KimchiLab/Camus/README.md

# Camus
Camera for homecage recordings of Mus musculus mice  
**"the whole of life can be summed up in an image"** - Albert Camus, *Between Yes and No*

### Contributors
Eyal Y. Kimchi  
Tushya Mehta  
Andrew Si-Zu Lu  
Nicholas Angulo  
Silas Staten-Lusty  
Vincent Im  
Riya Palkar  
Cyrus Nadazideh  
Grace Steward  
Camellia Neda Nakhjiri  
Ylang Guo  

This package also makes use of modifications of the pygrabber python package, released under the MIT license at https://github.com/bunkahle/pygrabber  

### Sample Image
The following is a representative image of Camus recordings, from a camera placed on the ceiling within a standard lab mouse homecage. The homecage is housed on a standard individually ventilated cage (IVC) rack.    
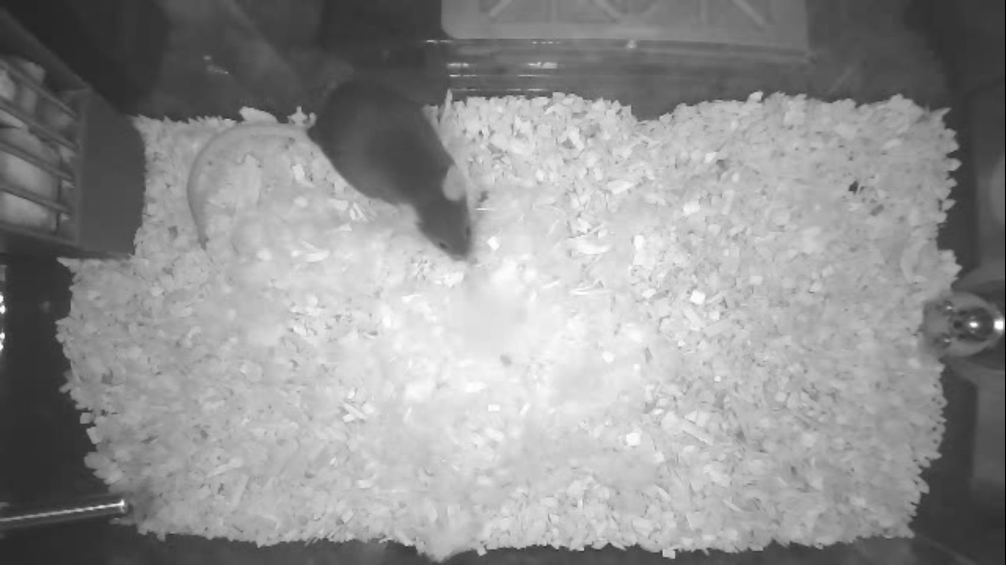
[picture p1: Examples/SampleCamusImageSingleMouse.jpg]
Sample Camus Image Single Mouse


### Repository Organization
The repository is split into Hardware and Code folders.
1. [Hardware](Hardware): Contains instructions and designs for building and setting up cameras
2. [Code](Code): Contains instructions and code for installing the software to collect and analyze data.

## Planned Additions
1. We will be updating 

### Preprints/Publications
Camus: a video-based framework for continuous behavioral monitoring in the mouse home-cage  
Tushya Mehta, Nicholas Angulo, Andrew Lu, Silas Staten-Lusty, Vincent Im, Riya Palkar, Cyrus Nadazideh, Grace Steward, Camelia Nakhjiri, Ylang Guo, Eyal Y Kimchi  
doi: https://doi.org/10.64898/2026.10.23.761437  
https://www.biorxiv.org/content/10.64898/2026.10.23.761437v1
