KimchiLab/Camus/Hardware/Figures/5b245129-4217-4f2a-90bd-1b663b835d09.jpg

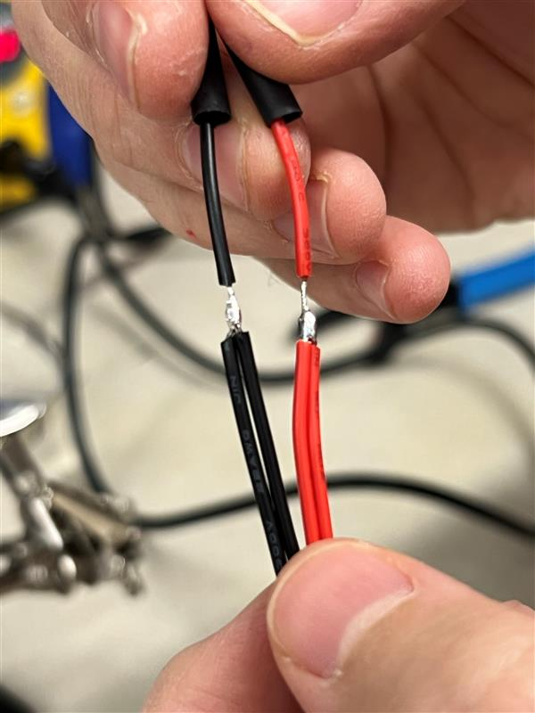
Hardware/Figures/5b245129-4217-4f2a-90bd-1b663b835d09.jpg
