KimchiLab/Camus/Hardware/Figures/68ceea74-401a-4e5f-a09a-84337bc96400.jpg

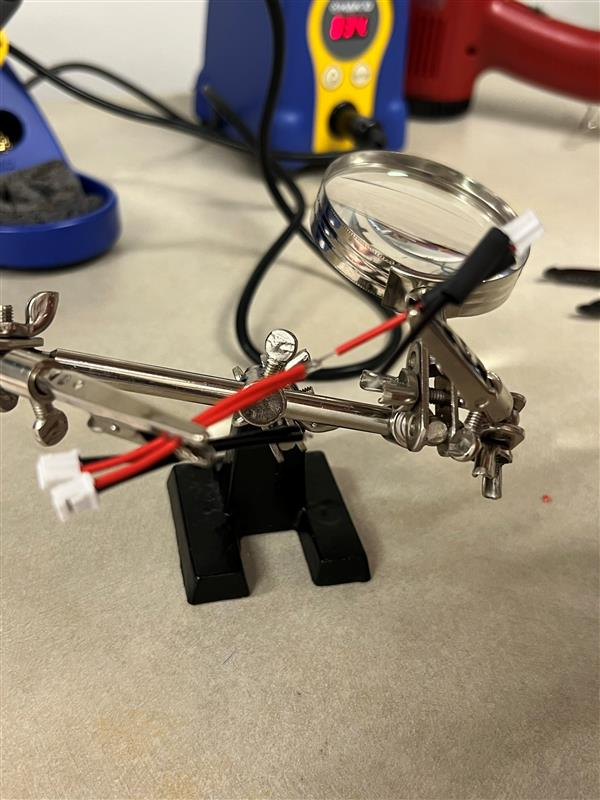
Hardware/Figures/68ceea74-401a-4e5f-a09a-84337bc96400.jpg
