KimchiLab/Camus/Hardware/Figures/food.jpeg

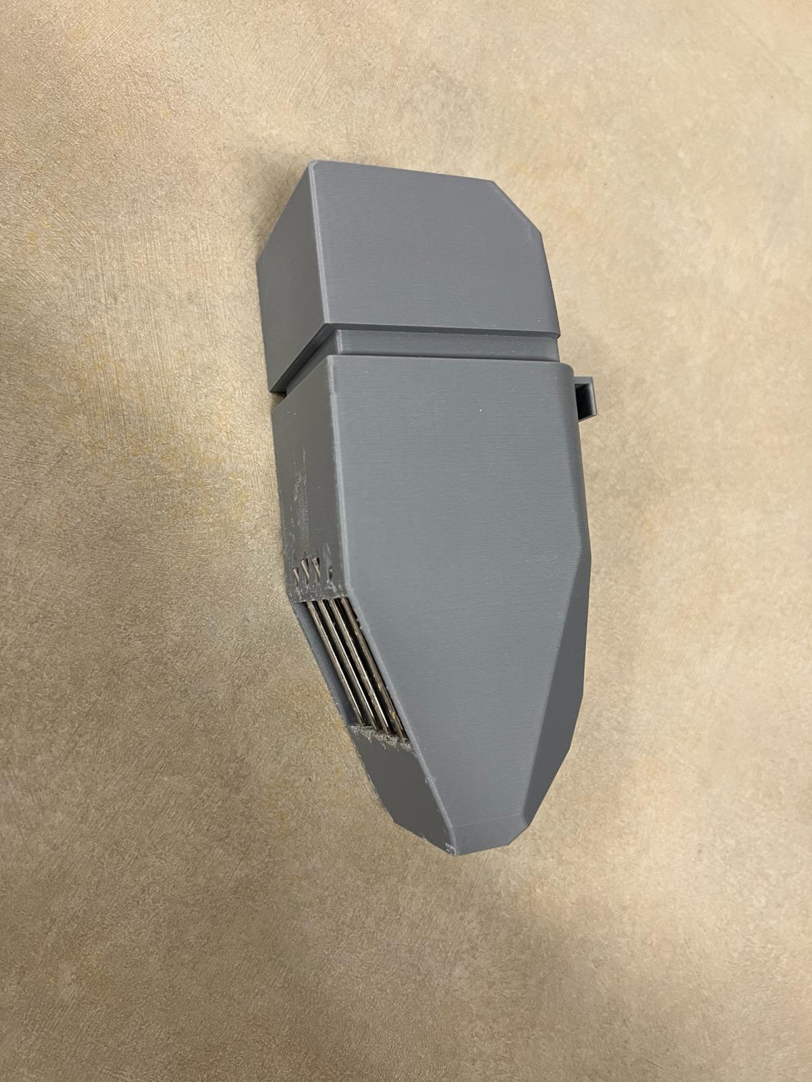
Hardware/Figures/food.jpeg
