KimchiLab/Camus/Hardware/Figures/led connected (2).jpeg

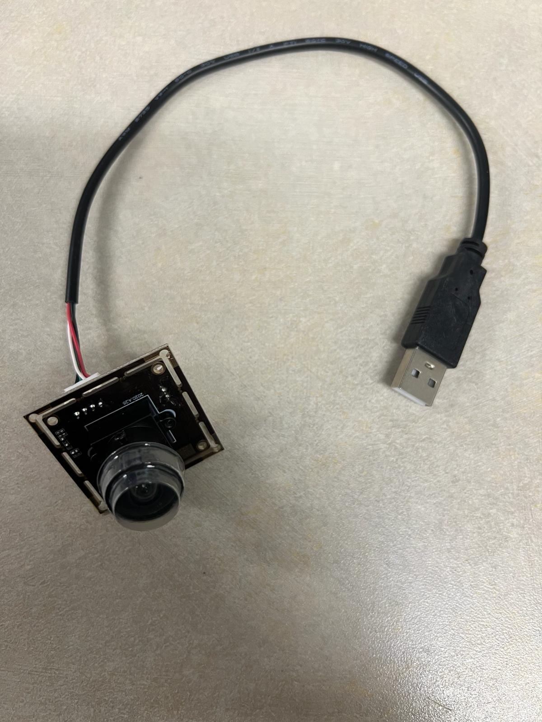
Hardware/Figures/led connected (2).jpeg
