KimchiLab/Camus/Hardware/Figures/pt 1.jpeg

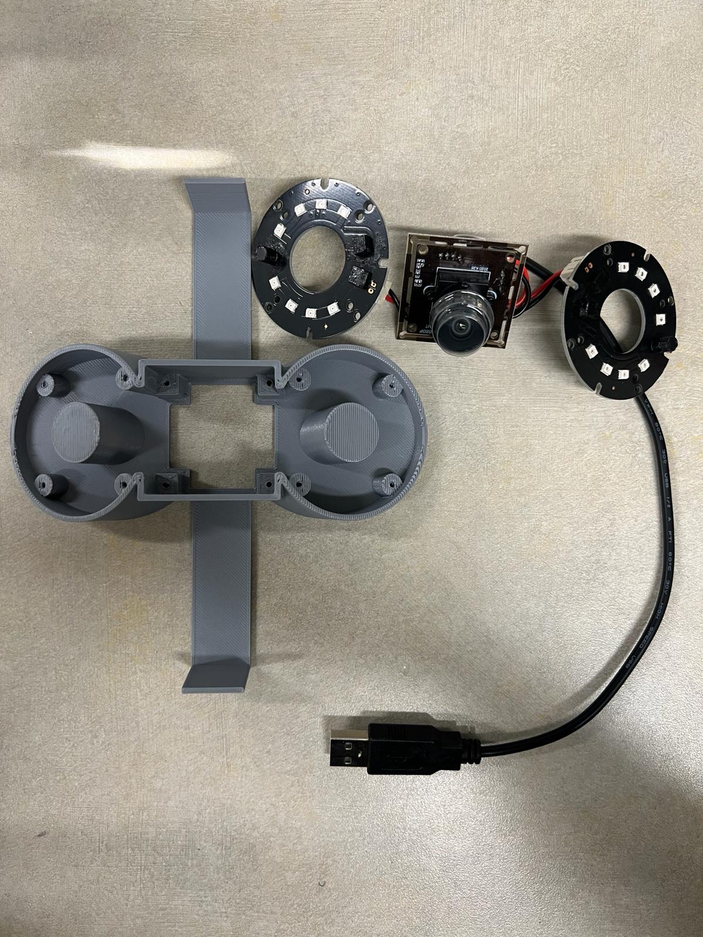
Hardware/Figures/pt 1.jpeg
