KimchiLab/Camus/Hardware/Figures/pt 3.jpeg

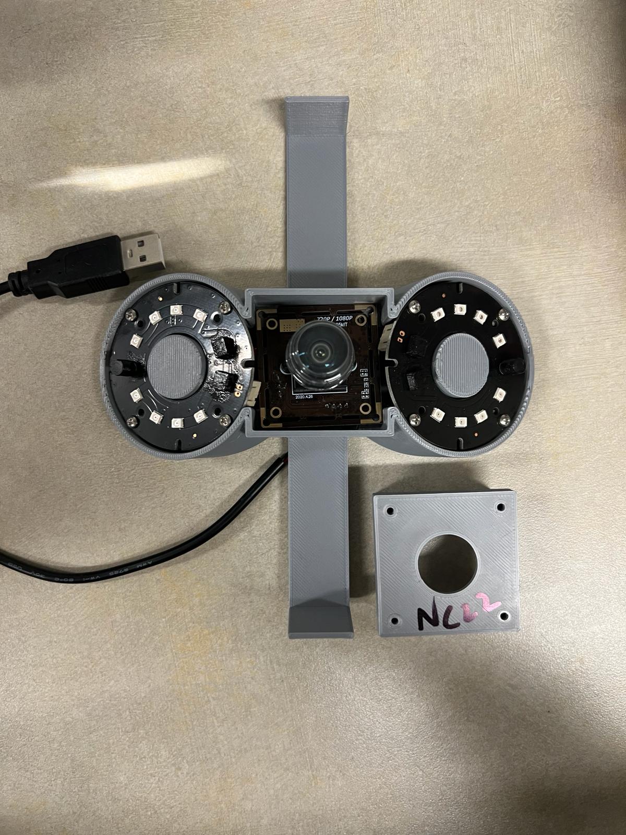
Hardware/Figures/pt 3.jpeg
