KimchiLab/Camus/Hardware/Figures/small tape thingy to stabalize pt2.jpeg

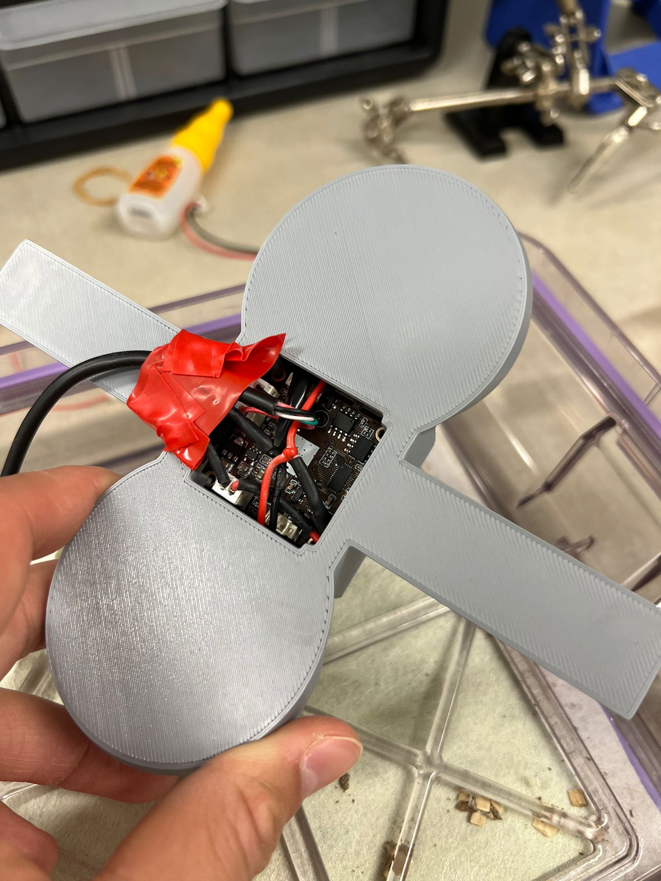
Hardware/Figures/small tape thingy to stabalize pt2.jpeg
