KimchiLab/Camus/Hardware/Figures/WhatsApp Image 2024-01-26 at 5.35.12 PM (2).jpeg

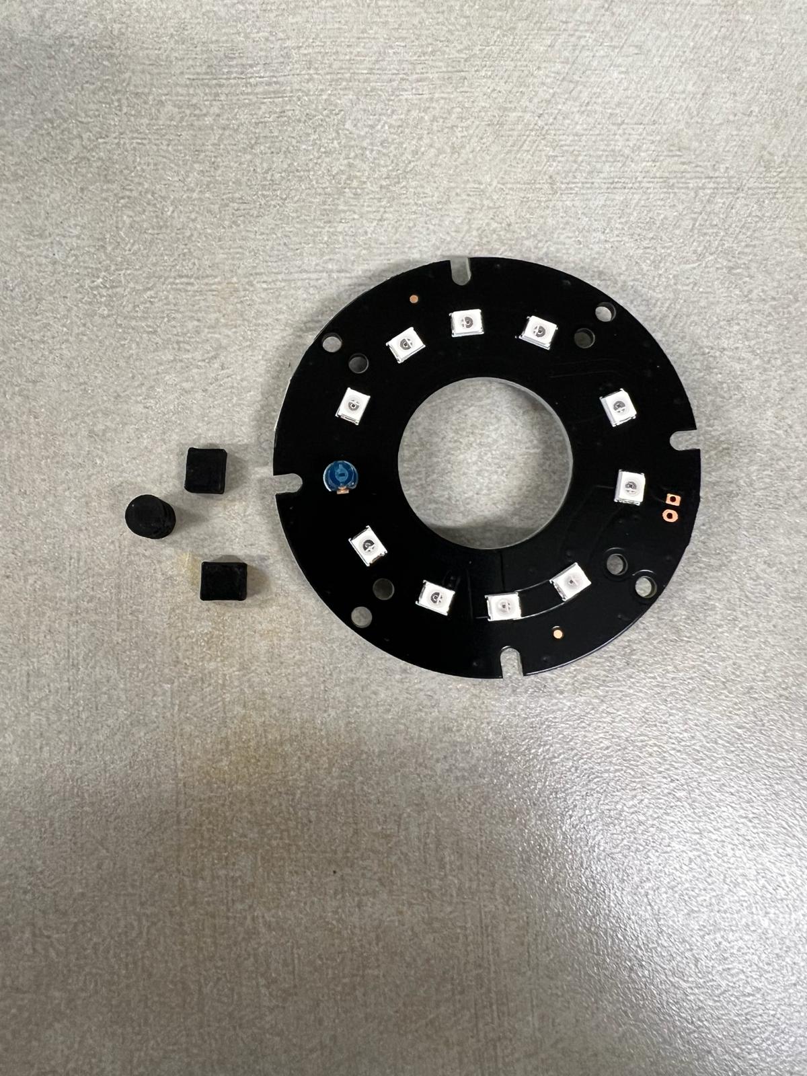
Hardware/Figures/WhatsApp Image 2024-01-26 at 5.35.12 PM (2).jpeg
