KimchiLab/Camus/Hardware/CamusPartsList.xlsx

Sheet: Camera Parts
Part Information | Needed Per Camera | For 20 | Notes | Unit Price | Cost Per Group | Manufacturer | Web | Alternative
Camera: ELP-USBFHD05MT-RH120 | 1 | 20 |  | $60.00 | $1200.00 | ELP | http://www.webcamerausb.com/2mp-1080p-usb-camera-c-42/?page=5
USB Cable for the camera | 1 | 20 |  | $1.03 | $20.60 | ELP | https://www.aliexpress.us/item/3256805417099241.html?gatewayAdapt=glo2usa
USB extension cable | 1 | 20 |  | $23.74 | $474.80 | Tripp Lite | https://www.amazon.com/Tripp-Lite-Hi-Speed-Extension-U026-016/dp/B0002D6QJO?th=1
LED Panels (IRXS10-120) | 2 | 40 | 120 degree panels for diffuse light | $7.20 | $288.00 | Spinel | https://www.spinelelectronics.com/product/irxs10-30/
JST cables | 1.5 | 30 | Need 1.5 for each, Come with camera | 0 | $0.00
Water Bottle: 80ml Hamster Small Pets Water Drinking Bottle Plastic Hangable Water Bottle | 1 | 20 |  | $0.91 | $18.20 | Sheep Famile House Store | https://www.aliexpress.us/item/3256806092078340.html | https://www.aliexpress.us/item/3256802367372956.html
Metal bars | 1 | 20 | Cut with saw to fit length of hopper | $8.90 | $178.00 | Grainger | https://www.grainger.com/product/GRAINGER-APPROVED-Stainless-Steel-Rod-303-3-796DH6
Screw: 3/16" screws (8) | 8 | 160 | Price includes 100 screws | $2.58 | $412.80 | Grainger | https://www.grainger.com/product/GRAINGER-APPROVED-Machine-Screw-2-56-Thread-1ZB22
Screw: 1 1/8" screws (4) | 4 | 80 | Price includes 100 screws | $4.14 | $331.20 | Grainger | https://www.grainger.com/product/Machine-Screw-2-56-Thread-1ZB21
Printer Filament (meters) | 85.79 | 1715.8 | in meters | $0.07 | $114.33
Stucco Tape |  | 1 |  | $11.48 | $11.48 | 3M | https://www.homedepot.com/p/3M-1-88-in-x-60-yds-48-mm-x-54-8-m-Stucco-Tape-3262/309077649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
Computer costs (for 20) |  | 0 | See Computer Parts sheet |  | $1879.52
 |  |  |  |  | $246.45
 |  |  |  |  |  |  |  |  | TOTAL Camera cost
 |  |  |  |  |  |  |  |  | $120.05

Sheet: 3dPrinted Parts
3d Printer Part | Quantitiy for 1 cage | Estimated Time to Print (min) | Estimated amount of filament (meters)
Hopper Cap & Hopper | 1 | 338 | 38.54
 | 1
Water Bottle Holder | 1 | 90 | 9.04
Water Bottle Holder Cap | 1 | 41 | 4.06
Camera Holder & Cover | 1 | 171 | 17.25
Photosensor Caps | 2 | 4 | 0.1
IR LED Caps | 4 | 8 | 0.24
Cage Cover Insert | 1 | 76 | 6.19
Cable Covers | 1 | 68 | 6.11
Cable Rings | 1 | 43 | 4.26
Total: |  | 839 | 85.79

Sheet: Computer Parts
Item | Vendor | VendorPart | Quantity | Unit Price | Total Price | Manufacturer | MfgPart | Web
RAIJINTEK THETIS Silver Classic, Alu. ATX PC Case, Supports Max. 280mm Length VGA Card, 170mm Height CPU Coolers, 4X HDDs,240mm Radiator on top, 1x 12025 LED Fan pre-Installed, 2X USB3.0, 7X PCI Slot | Amazon | B01MQS5IWM | 1 | 122.9 | $122.90 | RAIJINTEK | THETIS Classic | https://www.amazon.com/RAIJINTEK-Classic-Supports-Radiator-pre-Installed/dp/B01MQS5IWM/ref=sr_1_2
Corsair RM Series, RM750, 750 Watt, 80+ Gold Certified, Fully Modular Power Supply, Microsoft Modern Standby | Amazon | B07RF237B1 | 1 | 199.99 | $199.99 | Corsair | ‎CP-9020195-NA | https://www.amazon.com/CORSAIR-Certified-Modular-Microsoft-Standby/dp/B07RF237B1
ASUS Prime A620-PLUS WiFi Socket AM5 (LGA 1718) Ryzen 7000 Gaming Motherboard(DDR5,Dual M.2 Slots,DisplayPort/HDMI,Wi-Fi 5,Front USB 3.2 Gen 1 Type-C,Two-Way AI Noise Cancelation, Aura Sync) Heart 1 | Amazon | B0CBQW2C41 | 1 | 139.99 | $139.99 | ASUS | Prime A620-PLUS WiFi | https://www.amazon.com/ASUS-A620-PLUS-Motherboard-DisplayPort-Cancelation/dp/B0CBQW2C41/ref=sr_1_1
AMD Ryzen™ 9 7950X 16-Core, 32-Thread Unlocked Desktop Processor | Amazon | B0BBHD5D8Y | 1 | 536.91 | $536.91 |  |  | https://www.amazon.com/AMD-Ryzen-5950X-32-Thread-Processor/dp/B0815Y8J9N
Thermalright Phantom Spirit 120 SE Black CPU Cooler,Dual TL-C12B V2 PWM Fans and Double Towers, 7 Heat Pipes Heatsink Cooler,for AM4/AM5&Intel LGA1851/1700/115X/1200, Computer CPU Cooling,Black | Amazon | B0D93R3YY9 | 1 | 36.59 | $36.59 | ThermalRight | PS120SE BLACK | https://www.amazon.com/dp/B0D93R3YY9
CORSAIR VENGEANCE DDR5 RAM 32GB (2x16GB) 4800MHz CL40 Intel XMP iCUE Compatible Computer Memory - Black (CMK32GX5M2A4800C40) | Amazon | B09MTS5YH1 | 1 | 92.99 | $92.99 |  |  | https://www.amazon.com/CORSAIR-VENGEANCE-4800MHz-Compatible-Computer/dp/B09MTS5YH1?s=electronics
WD_BLACK SN850X NVMe SSD WDS400T2X0E - SSD - 4 TB - PCIe 4.0 x4 (NVMe) | CDWG | 7134252 | 1 | 372.16 | $372.16 | WD | WDS400T2X0E | https://www.cdwg.com/product/wd-black-sn850x-nvme-ssd-wds400t2x0e-ssd-4-tb-pcie-4.0-x4-nvme/7134252?pfm=srh
MHQJRH M.2 2280 SSD heatsink, Double-Sided Heat Sink, with Thermal Silicone pad for PC / PS5 M.2 PCIE NVMe SSD or M.2 SATA SSD | Amazon | B07KDDKDNN | 1 | 8.99 | $8.99 |  |  | https://www.amazon.com/heatsink-double-sided-matching-thermal-silicone/dp/B07KDDKDNN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
StarTech.com 4 Port USB 3.0 PCIe Card w/ 4 Dedicated Channels - UASP 5Gbps | CDWG | 3255376 | 4 | 92.25 | $369.00 | StarTech | PEXUSB3S44V | https://www.cdwg.com/product/startech.com-4-port-usb-3.0-pcie-card-w-4-dedicated-channels-uasp/3255376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
 |  |  |  |  | $1879.52

Sheet: Animal Facility Parts
Part Information | Description | Manufacturer
Rack- Allentown NexGen IVC system rack |  | Allentown
Blower - Ecoflo blower: Allentown |  | Allentown
Allentown Nexgen 500 Mouse cage (Standard cage) | Micro barrier top | Allentown
Animal Feed | Teklad LM-485 Mouse/Rat sterilizable diet | Teklad
Bedding (Aspen Sani Chips) | Heat treated coarse bedding | Nepco
Nestlet (NES360) | Compacted cotton fiber nesting material | Gusmer Enterprises
Used at Northwestern, but not in Camus: | Description | Manufacturer
Plastic igloo (K3327Mouse Igloo, Red | Red Igloo for mice | Bio-serv
Safe Harbor (K3583 Safe Harbor mouse retreat) | Red safe harbor for mice | Bio-serv
