KimchiLab/Camus/Hardware/3dPrint/CableRing/CableRingDuo.stl

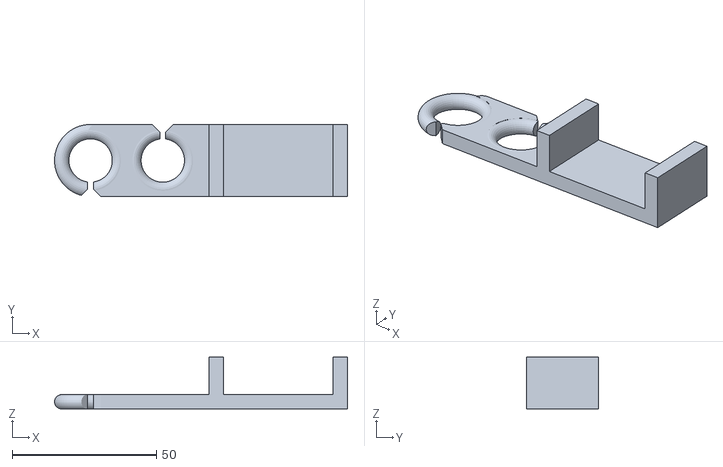
[picture p40: CAD file, 2026-10-27]
Hardware/3dPrint/CableRing/CableRingDuo.stl
101.5 x 25.0 x 18.0
