KimchiLab/Camus/Hardware/3dPrint/CageTopInsertGrating/CageTopInsertGrating.stl

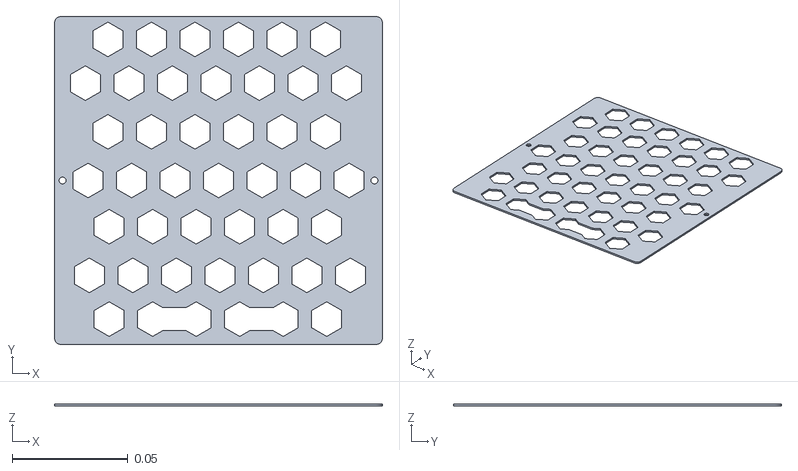
[picture p41: CAD file, 2026-10-27]
Hardware/3dPrint/CageTopInsertGrating/CageTopInsertGrating.stl
0.142 x 0.142 x 0.001
