KimchiLab/Camus/Hardware/3dPrint/CameraHolder/CameraHolder_UsbCover_100.stl

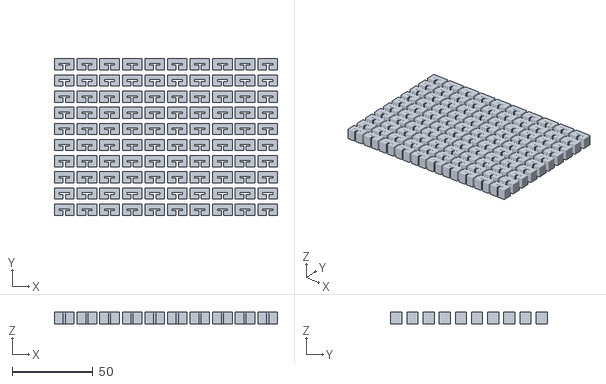
[picture p42: CAD file, 2026-10-27]
Hardware/3dPrint/CameraHolder/CameraHolder_UsbCover_100.stl
138.2 x 97.0 x 7.50
