KimchiLab/Camus/Hardware/3dPrint/FoodHopper/Food Hopper_Hopper.stl

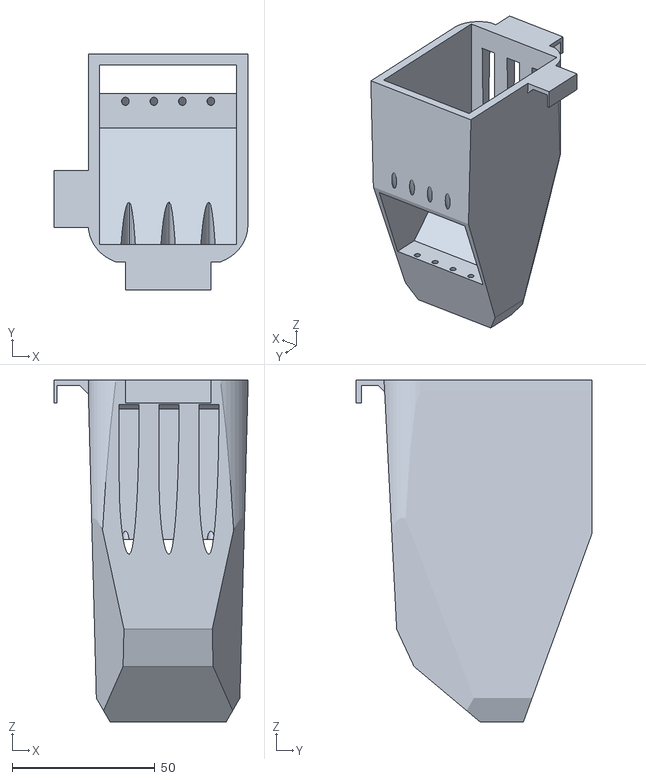
[picture p43: CAD file, 2026-10-27]
Hardware/3dPrint/FoodHopper/Food Hopper_Hopper.stl
68.0 x 82.9 x 120.0
