KimchiLab/Camus/Hardware/3dPrint/WaterBottleHolder/WaterBottleCap.stl

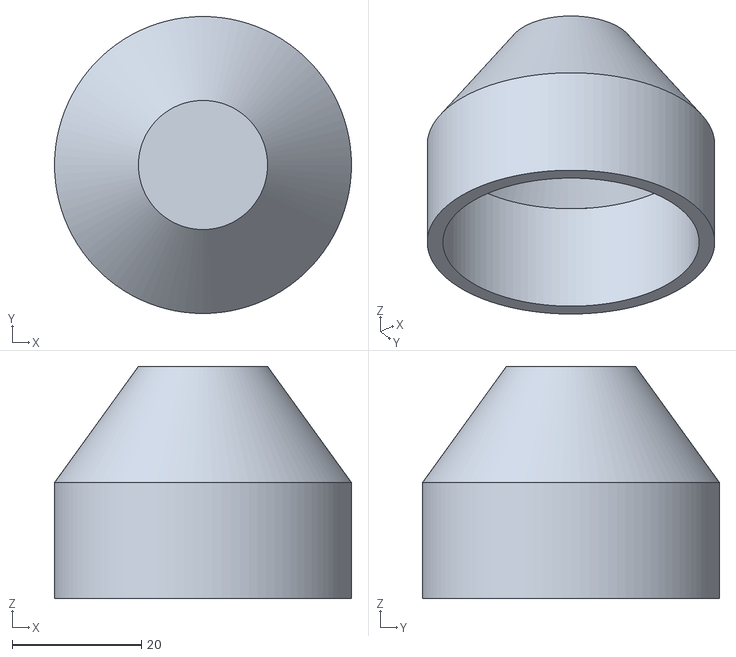
[picture p45: CAD file, 2026-10-27]
Hardware/3dPrint/WaterBottleHolder/WaterBottleCap.stl
46.0 x 46.0 x 36.0
