KimchiLab/Camus/Hardware/3dPrint/CameraHolder/CameraHolder_FlatLedCap_Spinel.stl

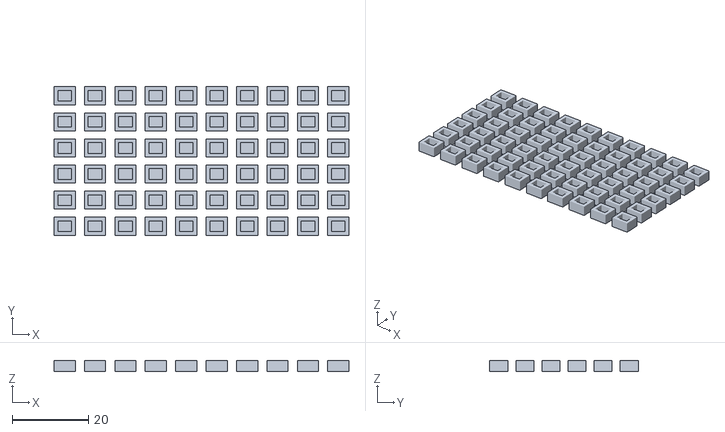
[picture p46: CAD file, 2026-10-27]
Hardware/3dPrint/CameraHolder/CameraHolder_FlatLedCap_Spinel.stl
77.6 x 39.1 x 3.00
