KimchiLab/Camus/Hardware/3dPrint/FoodHopper/Food Hopper_Cap.stl

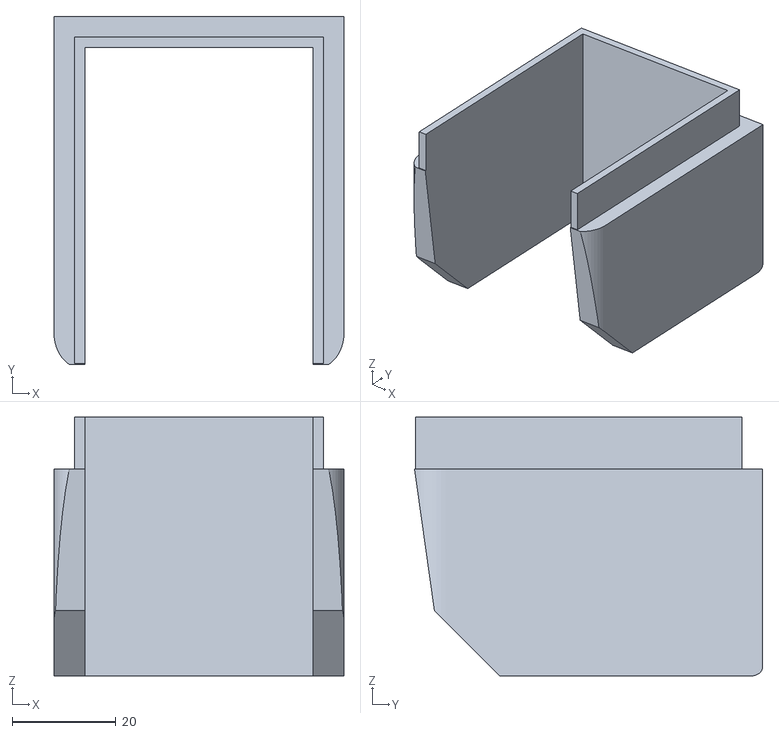
[picture p47: CAD file, 2026-10-27]
Hardware/3dPrint/FoodHopper/Food Hopper_Cap.stl
56.0 x 67.2 x 50.0
