KimchiLab/Camus/Hardware/3dPrint/UsbCover/CameraHolder_UsbCover_ActiveExt_TrippLite_Lower.stl

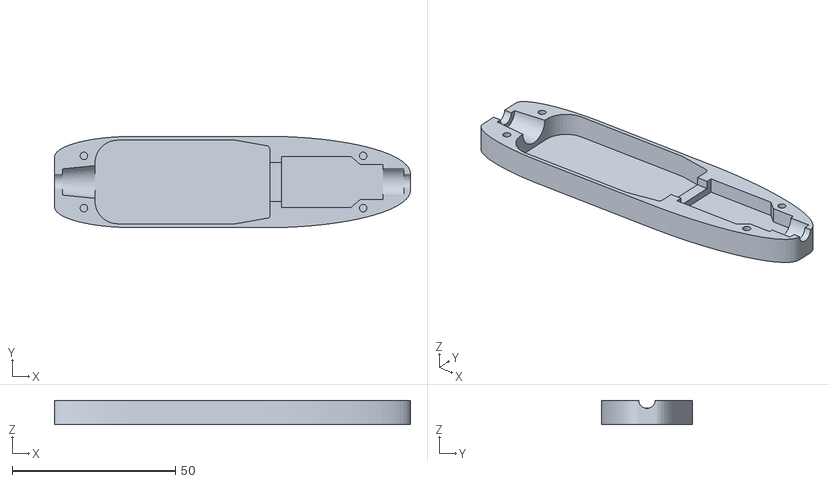
[picture p48: CAD file, 2026-10-27]
Hardware/3dPrint/UsbCover/CameraHolder_UsbCover_ActiveExt_TrippLite_Lower.stl
109.0 x 28.0 x 7.50
