KimchiLab/Camus/Hardware/3dPrint/WaterBottleHolder/WaterBottleHolder.stl

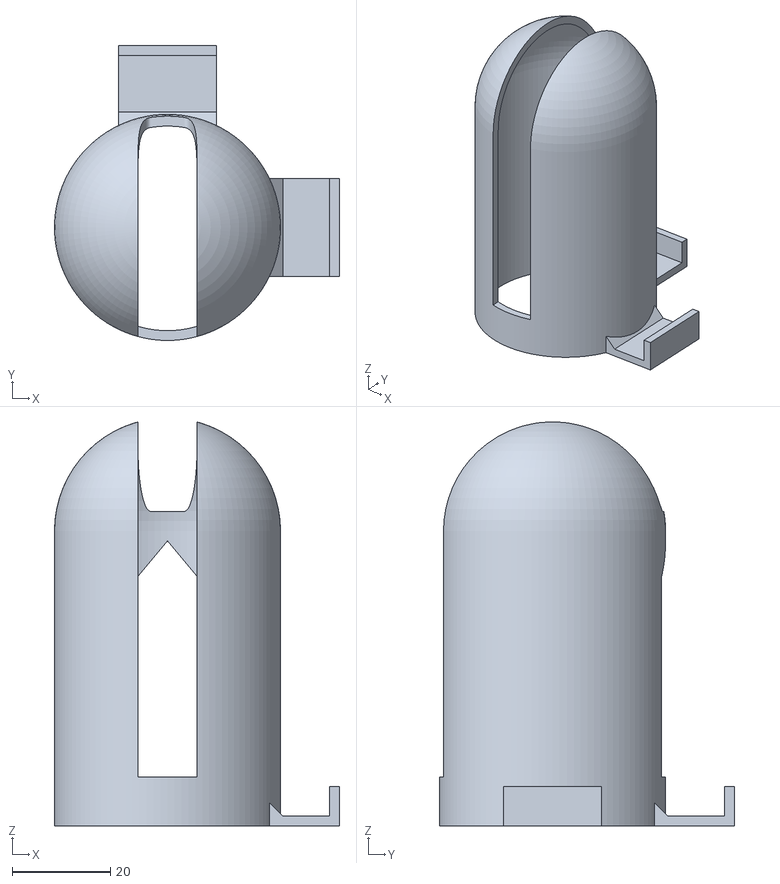
[picture p49: CAD file, 2026-10-27]
Hardware/3dPrint/WaterBottleHolder/WaterBottleHolder.stl
58.0 x 60.0 x 82.2
