KimchiLab/Camus/Hardware/3dPrint/CameraHolder/CameraHolder_PhotosensorCap_Spinel_Array.stl

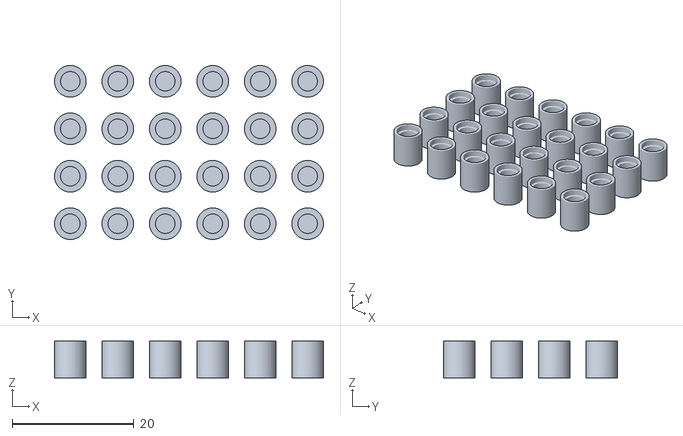
[picture p50: CAD file, 2026-10-27]
Hardware/3dPrint/CameraHolder/CameraHolder_PhotosensorCap_Spinel_Array.stl
44.2 x 28.6 x 6.00
