KimchiLab/Camus/Hardware/3dPrint/UsbCover/CameraHolder_UsbCover_NonActiveExt_C2G_Lower.stl

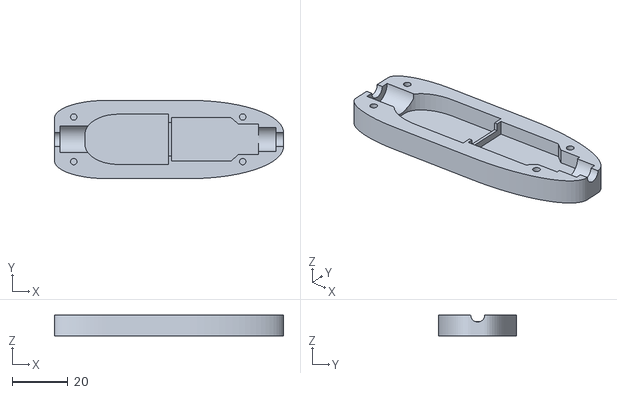
[picture p51: CAD file, 2026-10-27]
Hardware/3dPrint/UsbCover/CameraHolder_UsbCover_NonActiveExt_C2G_Lower.stl
82.0 x 28.0 x 7.50
