KimchiLab/Camus/Hardware/3dPrint/WaterBottleHolder/WaterBottleDryingRack.stl

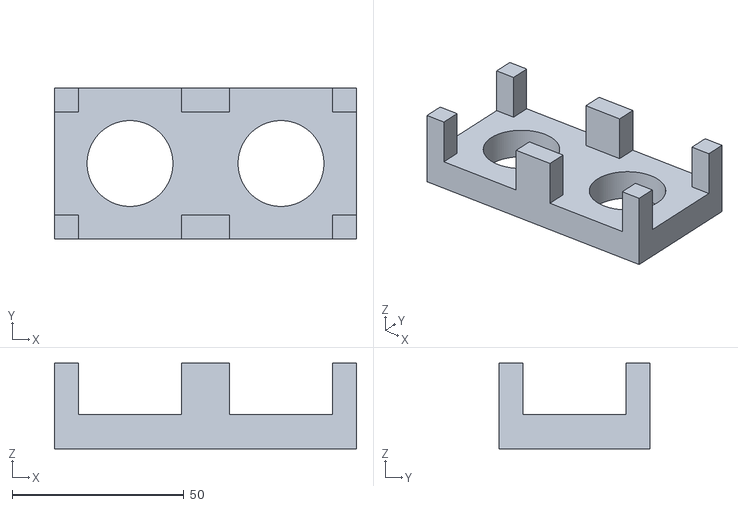
[picture p52: CAD file, 2026-10-27]
Hardware/3dPrint/WaterBottleHolder/WaterBottleDryingRack.stl
88.0 x 44.0 x 25.0
