KimchiLab/Camus/Hardware/3dPrint/CameraHolder/CameraHolder_UsbCover.stl

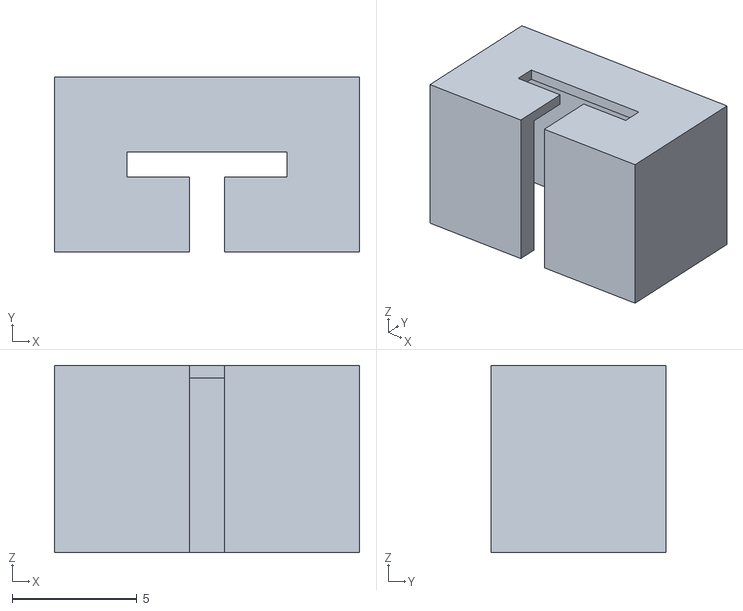
[picture p53: CAD file, 2026-10-27]
Hardware/3dPrint/CameraHolder/CameraHolder_UsbCover.stl
12.2 x 7.00 x 7.50
