KimchiLab/Camus/Hardware/3dPrint/CameraHolder/CameraHolder_Led_Spinel.stl

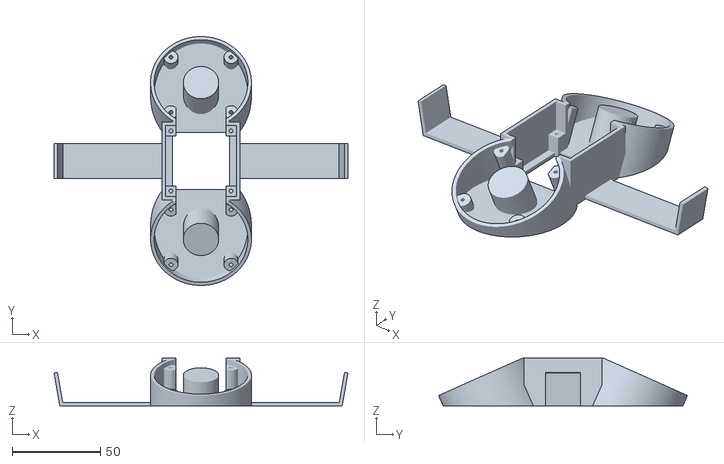
[picture p54: CAD file, 2026-10-27]
Hardware/3dPrint/CameraHolder/CameraHolder_Led_Spinel.stl
166.2 x 140.7 x 27.0
