KimchiLab/Camus/Hardware/3dPrint/CameraHolder/CameraHolder_CameraCover_Spinel.stl

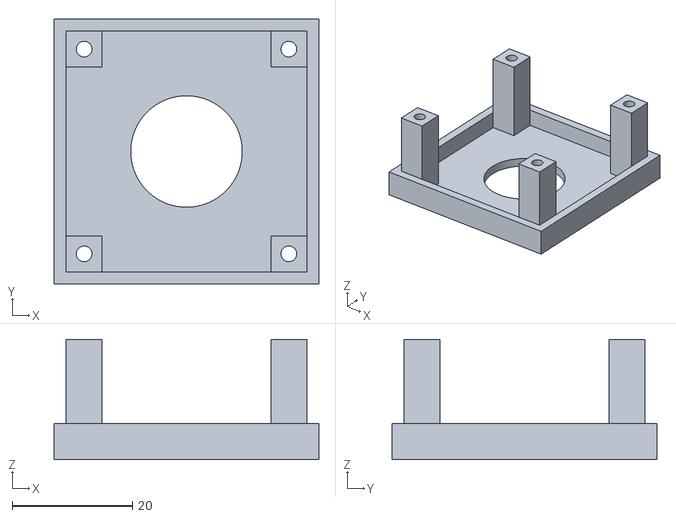
[picture p55: CAD file, 2026-10-27]
Hardware/3dPrint/CameraHolder/CameraHolder_CameraCover_Spinel.stl
44.0 x 44.0 x 20.0
