KimchiLab/Camus/Hardware/3dPrint/UsbCover/CameraHolder_UsbCover_ActiveExt_Monoprice_Upper.stl

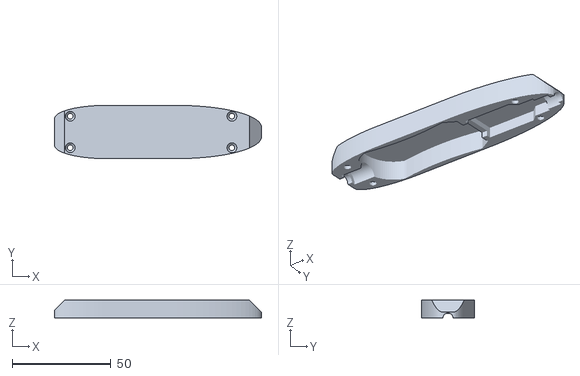
[picture p56: CAD file, 2026-10-27]
Hardware/3dPrint/UsbCover/CameraHolder_UsbCover_ActiveExt_Monoprice_Upper.stl
105.0 x 27.0 x 9.00
