KimchiLab/Camus/Hardware/3dPrint/UsbCover/CameraHolder_UsbCover_NonActiveExt_TrippLite.stl

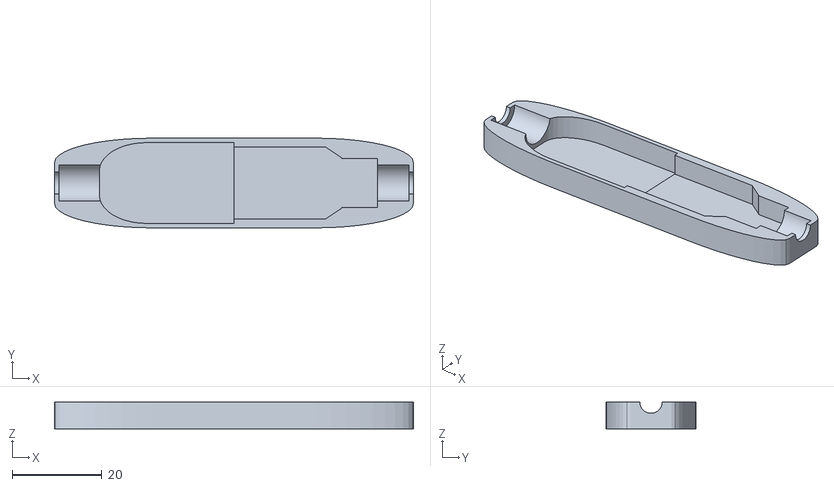
[picture p58: CAD file, 2026-10-27]
Hardware/3dPrint/UsbCover/CameraHolder_UsbCover_NonActiveExt_TrippLite.stl
80.0 x 20.0 x 6.00
