KimchiLab/Camus/(list of files, cad)

Other CAD files:
Hardware/3dPrint/UsbCover/CameraHolder_UsbCover_NonActiveExt_BESGOOD_Upper.stl
Hardware/3dPrint/UsbCover/CameraHolder_UsbCover_NonActiveExt_BESGOOD_Lower.stl
Hardware/3dPrint/UsbCover/CameraHolder_UsbCover_ActiveExt_TrippLite_Upper.stl
Hardware/3dPrint/CableRing/CableRingDuo.blend
Hardware/3dPrint/CageTopInsertGrating/CageTopInsertGrating.blend
Hardware/3dPrint/CameraHolder/CameraHolder_CameraCover_Spinel.blend
Hardware/3dPrint/CameraHolder/CameraHolder_FlatLedCap_Spinel.blend
Hardware/3dPrint/CameraHolder/CameraHolder_Led_Spinel.blend
Hardware/3dPrint/CameraHolder/CameraHolder_PhotosensorCap_Spinel.blend
Hardware/3dPrint/CameraHolder/CameraHolder_UsbCover.blend
Hardware/3dPrint/FoodHopper/Food Hopper.blend
Hardware/3dPrint/UsbCover/CameraHolder_UsbCover_ActiveExt_Monoprice.blend
Hardware/3dPrint/UsbCover/CameraHolder_UsbCover_ActiveExt_TrippLite.blend
Hardware/3dPrint/UsbCover/CameraHolder_UsbCover_NonActiveExt_BESGOOD.blend
Hardware/3dPrint/UsbCover/CameraHolder_UsbCover_NonActiveExt_C2G.blend
Hardware/3dPrint/UsbCover/CameraHolder_UsbCover_NonActiveExt_TrippLite.blend
Hardware/3dPrint/WaterBottleHolder/WaterBottleCap.blend
Hardware/3dPrint/WaterBottleHolder/WaterBottleDryingRack.blend
Hardware/3dPrint/WaterBottleHolder/WaterBottleHolder.blend
